JohnPattersonConsulting/SolarChargingStuff/Work-In-Progress PCB (V1.1)/Low_Voltage_Solar_Controller_V1.1.brd

## EAGLE design Work-In-Progress PCB (V1.1)/Low_Voltage_Solar_Controller_V1.1.brd (2024-05-12)

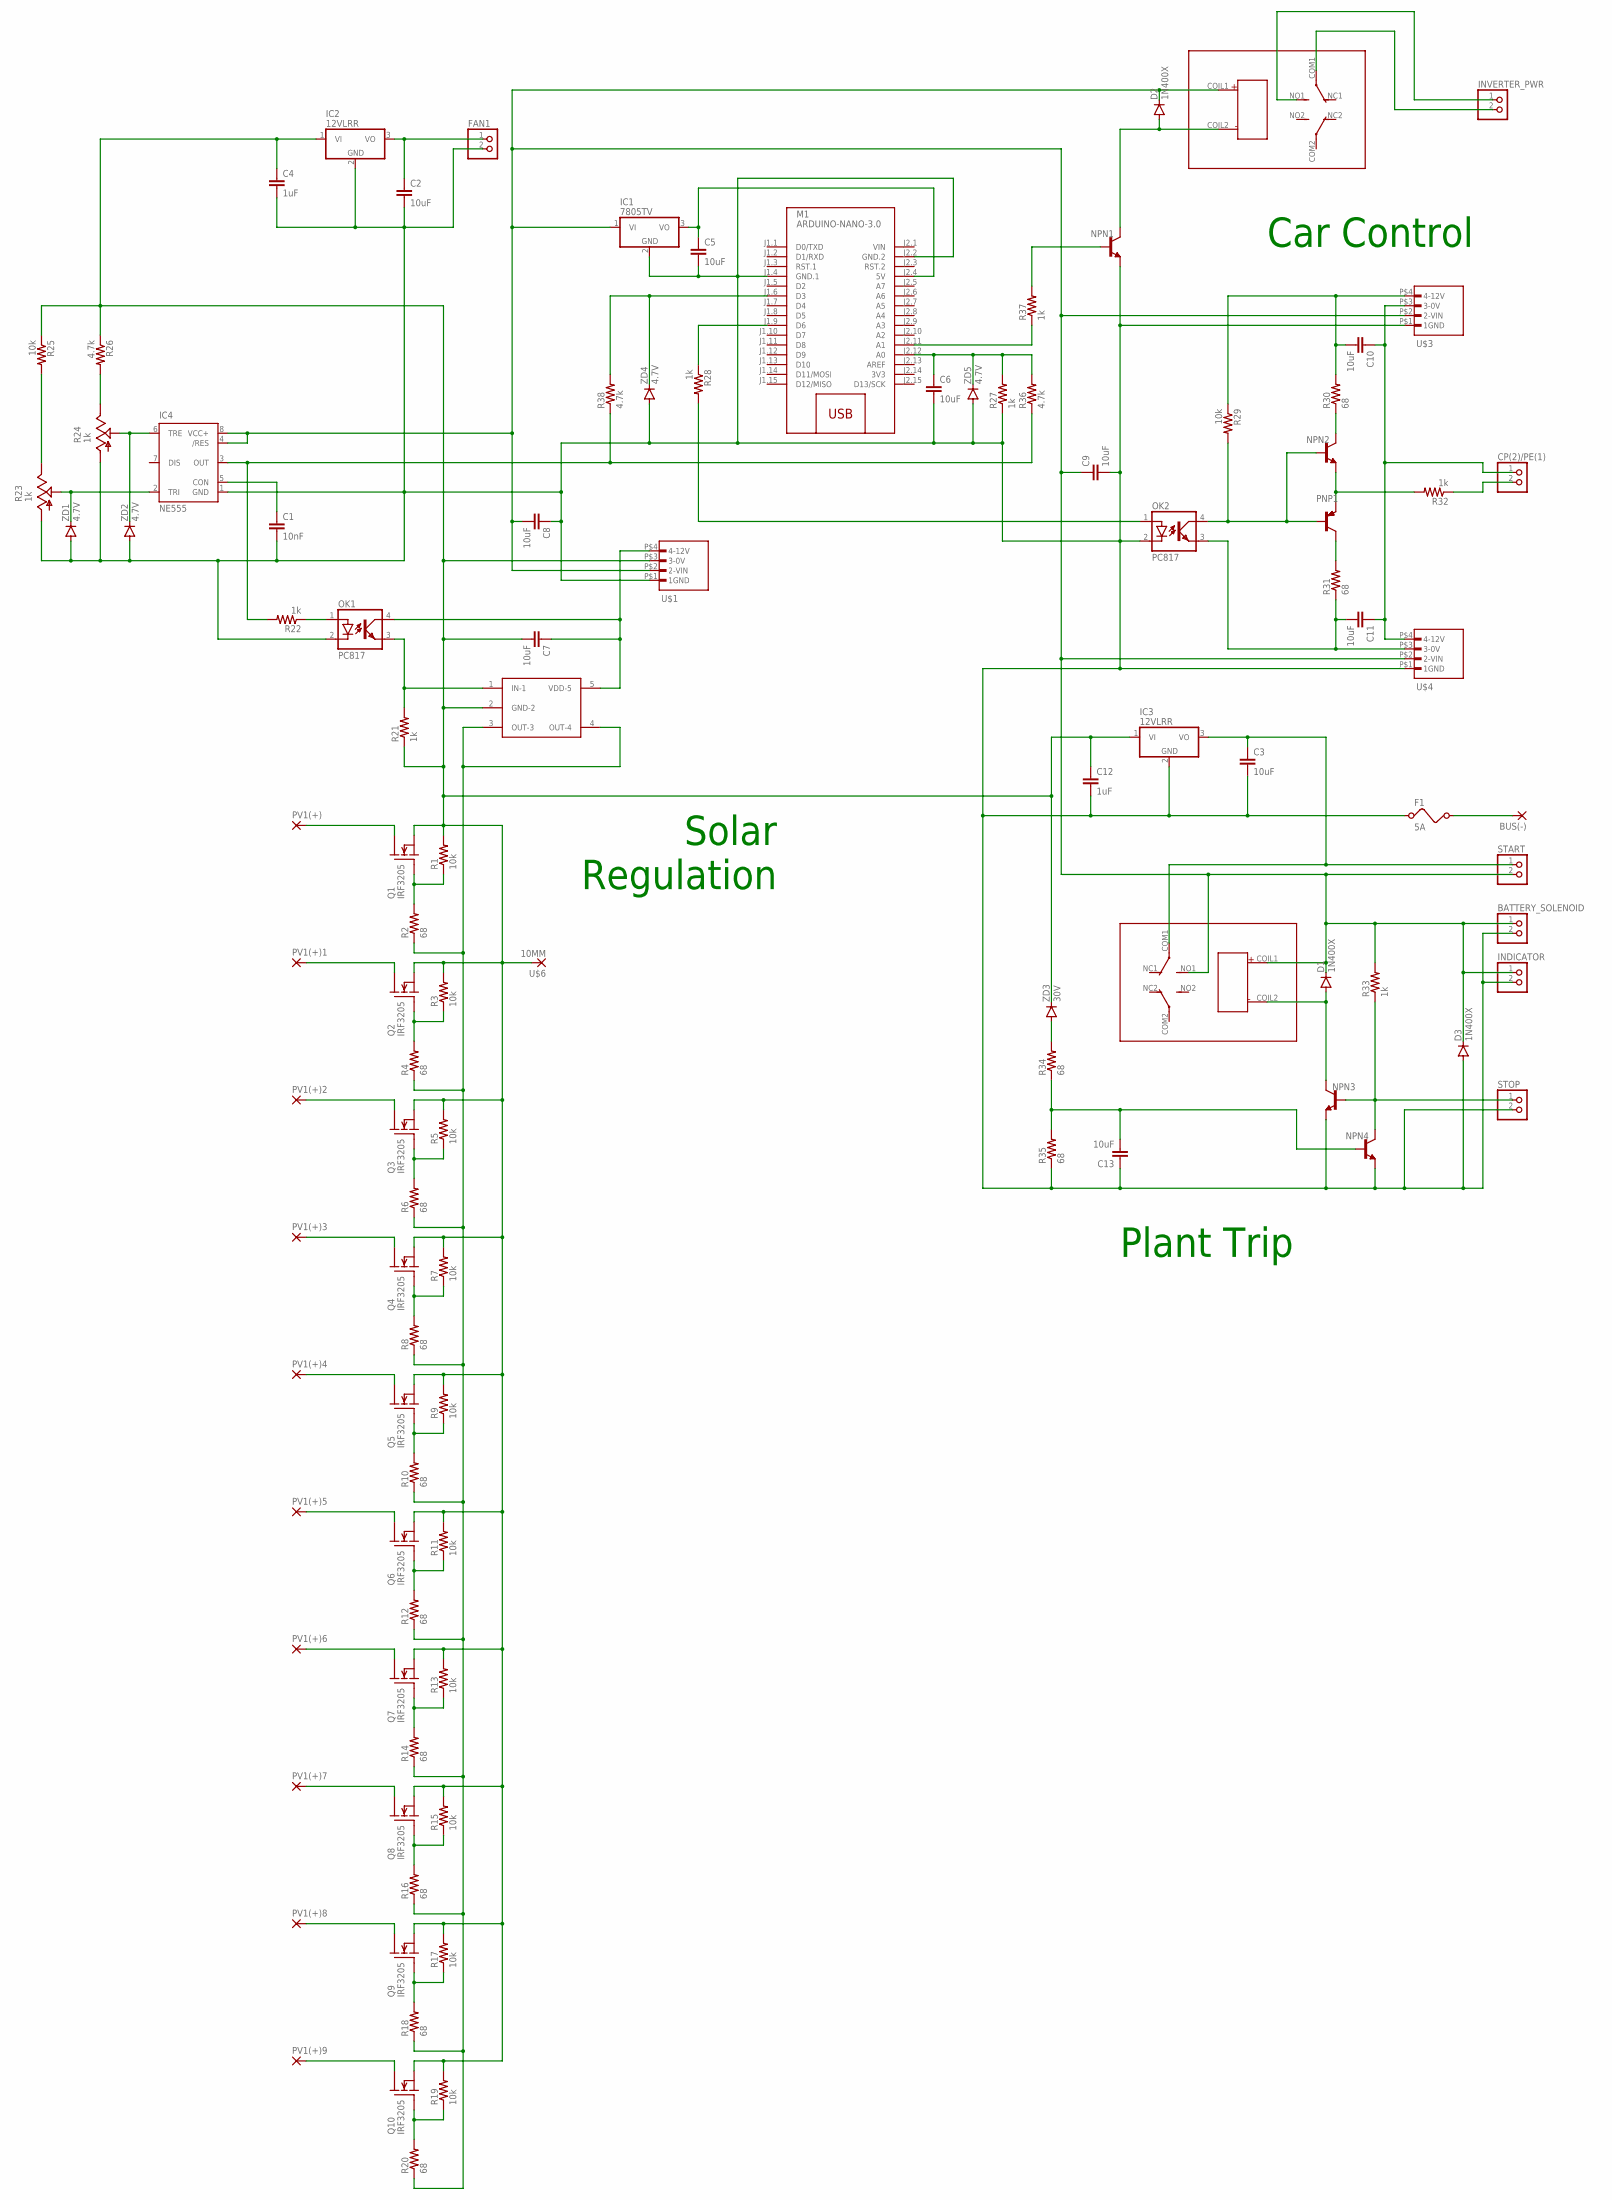
[picture p1: schematic Low_Voltage_Solar_Controller_V1.1.sch]

Parts:
BATTERY_SOLENOID: PINHD-1X2; 1X02
BUS(-): 5MM_PAD; 5MM
C1: 10nF; C0603
C2, C3, C5, C6, C7, C8, C9, C10, C11, C13: 10uF; C0805
C4, C12: 1uF; C0805
CP(2)/PE(1): PINHD-1X2; 1X02
D1, D2, D3: 1N400X; DO41-10
F1: 5A; FUSE_HOLDER
FAN1: PINHD-1X2; 1X02
IC1: 7805TV; TO220V
IC2, IC3: 12VLRR; TO220V
IC4: NE555; DIL-08
INDICATOR: PINHD-1X2; 1X02
INVERTER_PWR: PINHD-1X2; 1X02
M1: ARDUINO-NANO-3.0
NPN1, NPN2, NPN3, NPN4: -NPN-TO92-EBC; TO92-EBC
OK1, OK2: PC817; DIL04
PNP1: BCX58-PNP-TO92-EBC; TO92-EBC
PV1(+), PV1(+)1, PV1(+)2, PV1(+)3, PV1(+)4, PV1(+)5, PV1(+)6, PV1(+)7, PV1(+)8, PV1(+)9: 5MM_PAD; 5MM
Q1, Q2, Q3, Q4, Q5, Q6, Q7, Q8, Q9, Q10: IRF3205; TO220
R1, R3, R5, R7, R9, R11, R13, R15, R17, R19, R25, R29: 10k; R0805
R2, R4, R6, R8, R10, R12, R14, R16, R18, R20, R30, R31, R34, R35: 68; R0805
R21, R22, R27, R28, R32, R33, R37: 1k; R0805
R23, R24: 1k; RJ9W
R26, R36, R38: 4.7k; R0805
START: PINHD-1X2; 1X02
STOP: PINHD-1X2; 1X02
U$1, U$3, U$4: IB0512S-W75R3
U$2: NCP51100; SOT23-5
U$5, U$8: J104D2C12VDC.20S
U$6: 10MM
ZD1, ZD2, ZD4, ZD5: 4.7V; SOD-123_MINI-SMA
ZD3: 30V; DO214AA

Connections:
3V3: M1.J2.14 (3V3)
unnamed: PV1(+).P$1, Q1.2 (D)
unnamed: C4.1, C7.2, C12.1, IC2.1 (VI), IC3.1 (VI), Q1.3 (S), Q2.3 (S), Q3.3 (S), Q4.3 (S), Q5.3 (S), Q6.3 (S), Q7.3 (S), Q8.3 (S), Q9.3 (S), Q10.3 (S), R1.2, R3.2, R5.2, R7.2, R9.2, R11.2, R13.2, R15.2, R17.2, R19.2, R21.1, R25.1, R26.1, U$1.P$3 (3-0V), U$2.2 (GND-2), U$6.P$1, ZD3.C
unnamed: Q1.1 (G), R1.1, R2.2
unnamed: PV1(+)1.P$1, Q2.2 (D)
unnamed: M1.J1.6 (D3), R38.2, ZD4.C
unnamed: Q2.1 (G), R3.1, R4.2
unnamed: PV1(+)2.P$1, Q3.2 (D)
unnamed: Q3.1 (G), R5.1, R6.2
unnamed: PV1(+)3.P$1, Q4.2 (D)
unnamed: C5.1, IC1.3 (VO), M1.J2.4 (5V)
unnamed: Q4.1 (G), R7.1, R8.2
unnamed: PV1(+)4.P$1, Q5.2 (D)
unnamed: Q5.1 (G), R9.1, R10.2
unnamed: PV1(+)5.P$1, Q6.2 (D)
unnamed: Q6.1 (G), R11.1, R12.2
unnamed: PV1(+)6.P$1, Q7.2 (D)
unnamed: Q7.1 (G), R13.1, R14.2
unnamed: PV1(+)7.P$1, Q8.2 (D)
unnamed: Q8.1 (G), R15.1, R16.2
unnamed: PV1(+)8.P$1, Q9.2 (D)
unnamed: Q9.1 (G), R17.1, R18.2
unnamed: PV1(+)9.P$1, Q10.2 (D)
unnamed: Q10.1 (G), R19.1, R20.2
unnamed: R2.1, R4.1, R6.1, R8.1, R10.1, R12.1, R14.1, R16.1, R18.1, R20.1, U$2.3 (OUT-3), U$2.4 (OUT-4)
unnamed: OK1.3 (EMIT), R21.2, U$2.1 (IN-1)
unnamed: C7.1, OK1.4 (COL), U$1.P$4 (4-12V), U$2.5 (VDD-5)
unnamed: BATTERY_SOLENOID.1, C8.2, C9.1, D1.C, D2.C, D3.C, IC1.1 (VI), IC4.4 (/RES), IC4.8 (VCC+), INDICATOR.1, R33.2, START.2, U$1.P$2 (2-VIN), U$3.P$2 (2-VIN), U$4.P$2 (2-VIN), U$5.COIL1, U$8.COIL1, U$8.NO1
unnamed: OK1.1 (A), R22.1
unnamed: BATTERY_SOLENOID.2, C1.2, C2.2, C3.2, C4.2, C5.2, C6.2, C8.1, C9.2, C12.2, C13.1, D3.A, F1.P$1 (1), F1.P$2 (1), FAN1.2, IC1.2 (GND), IC2.2 (GND), IC3.2 (GND), IC4.1 (GND), INDICATOR.2, M1.J1.4 (GND.1), M1.J2.2 (GND.2), NPN1.E, NPN3.E, NPN4.E, OK1.2 (C), OK2.2 (C), R23.A, R24.A, R27.1, R35.1, STOP.2, U$1.P$1 (1GND), U$3.P$1 (1GND), U$4.P$1 (1GND), ZD1.A, ZD2.A, ZD4.A, ZD5.A
unnamed: C1.1, IC4.5 (CON)
unnamed: C2.1, FAN1.1, IC2.3 (VO)
unnamed: IC4.6 (TRE), R24.S, ZD2.C
unnamed: IC4.2 (TRI), R23.S, ZD1.C
unnamed: R23.E, R25.2
unnamed: R24.E, R26.2
unnamed: C6.1, M1.J2.12 (A0), R27.2, R36.2, ZD5.C
unnamed: M1.J1.9 (D6), R28.1
unnamed: OK2.1 (A), R28.2
unnamed: NPN2.B, OK2.4 (COL), PNP1.B, R29.2
unnamed: C10.1, C11.1, CP(2)/PE(1).1, U$3.P$3 (3-0V), U$4.P$4 (4-12V)
unnamed: C11.2, OK2.3 (EMIT), R31.1, U$4.P$3 (3-0V)
unnamed: C10.2, R29.1, R30.2, U$3.P$4 (4-12V)
unnamed: NPN2.E, PNP1.E, R32.2
unnamed: PNP1.C, R31.2
unnamed: NPN2.C, R30.1
unnamed: CP(2)/PE(1).2, R32.1
unnamed: BUS(-).P$1, F1.P$3 (2), F1.P$4 (2)
unnamed: D1.A, NPN3.C, U$8.COIL2
unnamed: NPN3.B, NPN4.C, R33.1, STOP.1
unnamed: C13.2, NPN4.B, R34.1, R35.2
unnamed: R34.2, ZD3.A
unnamed: C3.1, IC3.3 (VO), START.1, U$8.COM1
unnamed: M1.J2.11 (A1), R37.1
unnamed: IC4.3 (OUT), R22.2, R36.1, R38.1
unnamed: NPN1.B, R37.2
unnamed: D2.A, NPN1.C, U$5.COIL2
unnamed: INVERTER_PWR.2, U$5.COM1
unnamed: INVERTER_PWR.1, U$5.NO1
VIN: M1.J2.1 (VIN)

Notes on the sheet:
Car Control
Solar Regulation
Plant Trip

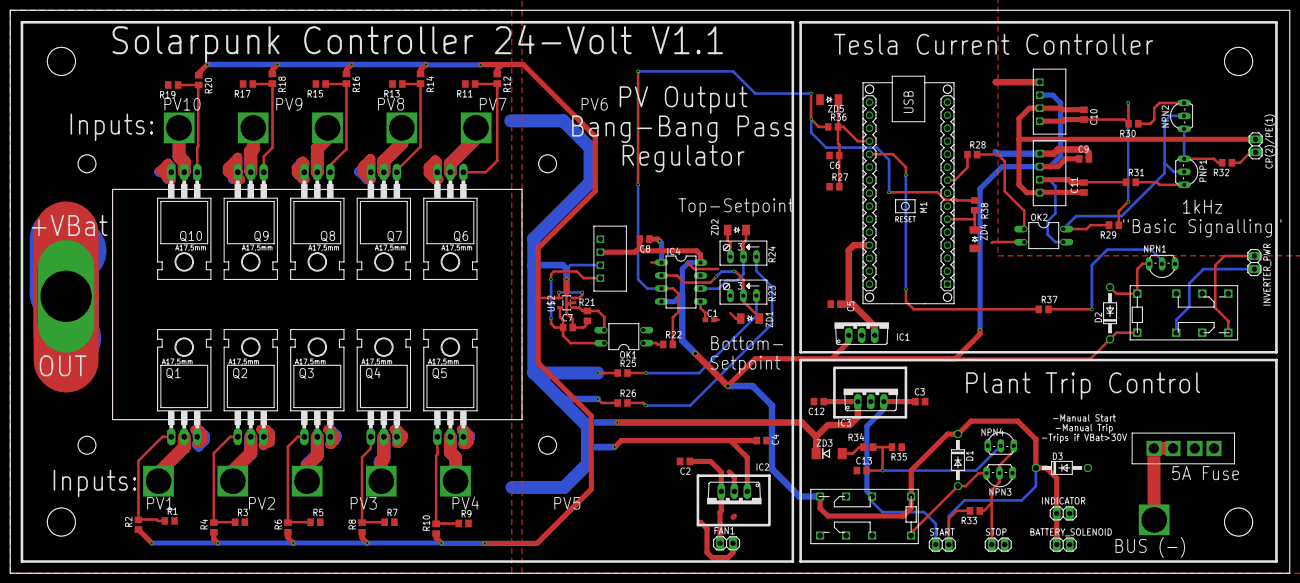
[picture p2: board Low_Voltage_Solar_Controller_V1.1.brd from above]

Board: 2 copper layers, 250.0 x 110.0 mm, 107 parts (0 on the bottom side), 58 nets.
